rogertheriault/thing-thermometer/assets/gas-stove-bg.jpg

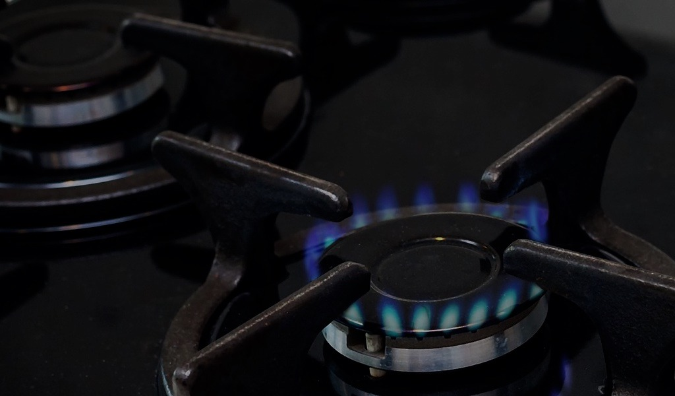
assets/gas-stove-bg.jpg
