rogertheriault/thing-thermometer/assets/thermometer-512.png

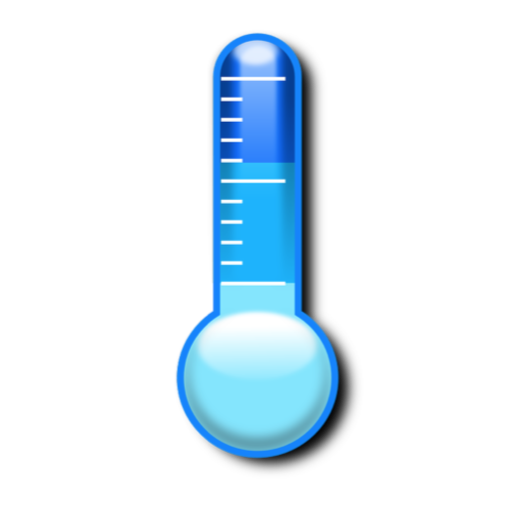
assets/thermometer-512.png
