rogertheriault/thing-thermometer/img/display.jpg

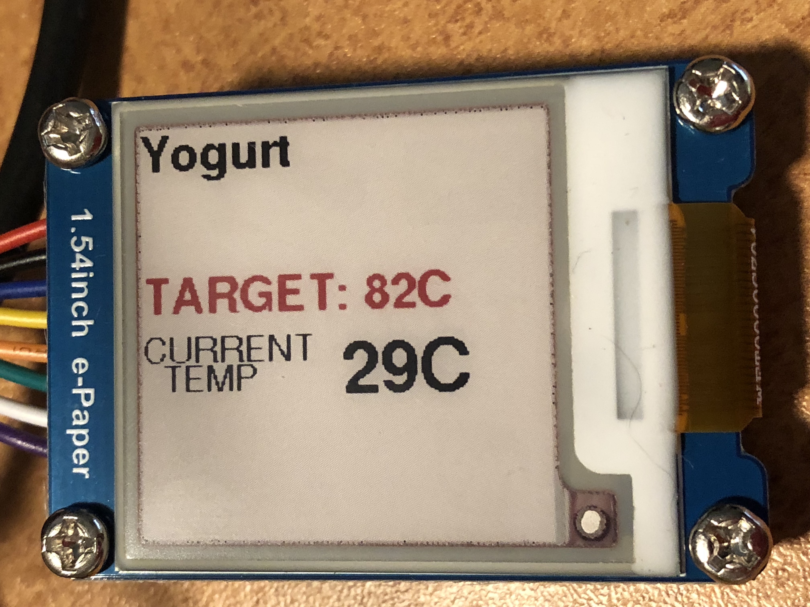
img/display.jpg
