rogertheriault/thing-thermometer/ThermometerAWSIoT/display.h

 
/**
 * E-paper display code
 */
 
#include <SPI.h>
#include <GxEPD.h>

#define DISPLAY_BGCOLOR GxEPD_WHITE
#define DISPLAY_FGCOLOR GxEPD_BLACK
#define DISPLAY_HICOLOR GxEPD_BLACK

// if you have other sizes, see the GxEPD library examples
#ifdef DISPLAY_3COLOR
#include <GxGDEW0154Z04/GxGDEW0154Z04.cpp>  // 1.54" b/w/r
#define DISPLAY_HICOLOR GxEPD_RED
#else
#include <GxGDEP015OC1/GxGDEP015OC1.cpp> // 1.54" b/w
#endif
// free fonts from Adafruit_GFX
#include <Fonts/FreeSans9pt7b.h>
#include <Fonts/FreeSansBold12pt7b.h>
#include <Fonts/FreeSansBold18pt7b.h>

#include <GxIO/GxIO_SPI/GxIO_SPI.cpp>
#include <GxIO/GxIO.cpp>


GxIO_Class io(SPI, EPAPER_CS, EPAPER_DC, EPAPER_RST);
GxEPD_Class display(io, EPAPER_RST, EPAPER_BUSY);


// update the e-paper display
void updateDisplay() {
  if ( ! display_update) {
    return;
  }
  display_update = false;
  
  display.fillScreen(DISPLAY_BGCOLOR);
  display.setTextColor(DISPLAY_FGCOLOR);

  Serial.print(F("DISPLAY heap size: "));
  Serial.println(ESP.getFreeHeap());

  /*
  // test
  // get a bitmap and size from a SPIFFS file
  uint16_t bmW, bmH;
  uint8_t *myBitmap = getBitmapFromFS("/yogurt.bin", bmW, bmH);
  display.drawBitmap(myBitmap, 0, 30, bmW, bmH, DISPLAY_FGCOLOR);
  Serial.print(F("DRAW heap size: \n"));
  Serial.println(ESP.getFreeHeap());
  display.update();
  Serial.print(F("UPDATE heap size: "));
  Serial.println(ESP.getFreeHeap());
  //delete [] myBitmap;
  Serial.print(F("DELETE heap size: "));
  Serial.println(ESP.getFreeHeap());
  return;
*/
   
  // what we're cooking
  display.setFont(&FreeSansBold12pt7b);
  display.setCursor(0, 20);
  // TODO center
  display.print( recipe_title );

  // battery
  //display.setCursor(160, 20);
  //display.print( ESP.getVcc() );

  // current temperature & step
  display.setFont(&FreeSans9pt7b);
  display.setCursor(0, 40);


  display.print( recipe_step_text );

  display.setCursor(0, 114);
  display.print(F("CURRENT"));
  display.setCursor(10, 128);
  display.print(F("TEMP"));
  display.setCursor(0, 32);

  // if the alarm's on, temp should be red
  if (in_alarm_state) {
    display.setTextColor(DISPLAY_HICOLOR);
  }
  if (currentTemp > 0) {
    display.setFont(&FreeSansBold18pt7b);
    display.setCursor(100, 130);
    display.print(currentTemp);
    display.println(F("C"));
  } else {
    display.setTextColor(DISPLAY_HICOLOR);
    display.setCursor(100, 130);
    // TODO icon here
    display.println(F("probe!"));
  }

  // if alarm is enabled show target temp(s)
  if (watching_high || watching_low) {
    display.setFont(&FreeSansBold12pt7b);
    display.setTextColor(DISPLAY_HICOLOR);
    display.setCursor(0, 90);
    display.print(F("TARGET: "));
    if (watching_low) {
      display.print(alarm_low);
    }
    if (watching_low && watching_high) {
      display.print(F("-"));
    }
    if (watching_high) {
      display.print(alarm_high);
    }
    display.print(F("C"));
  }

  display.update();
}
