rogertheriault/thing-thermometer/ThermometerAWSIoT/config-sample.h

// KEYS

// Keep this in config.h and keep it private!
// Even so, keep your devices secure, do not use this method
// for a production device

/*********WiFi settings*******/
#define WLAN_SSID "your-wifi-ssid"
#define WLAN_PASS "your-wifi-passphrase"
/*****************************/

/*********AWS IoT Thing settings*******/
#define AWS_SERVERPORT 443
#define AWS_REGION "us-east-1"
#define AWS_ENDPOINT "your-endpoint.iot.us-east-1.amazonaws.com"
#define THING_ID "your-thing-id"
#define AWS_KEY_ID "your-aws-key-id"
#define AWS_KEY_SECRET "your-aws-key-secret"

/*********S3 Settings********/
#define THING_DATA "http://s3.amazonaws.com/my-bucket"
#define RECIPES_URL "http://s3.amazonaws.com/my-bucket/recipes.json"
