rogertheriault/thing-thermometer/(commit log)

2018-01-08 initial (working) version of Arduino/ESP8266 code
2018-01-10 construct update JSON, parse inbound JSON correctly, and add cooking mode to display
    [ThermometerAWSIoT.ino]
2018-01-25 sample interactions
2018-01-26 use recipes.json on device
2018-02-18 breathe LEDS breathe
2018-02-19 update sample config
2018-02-24 couple more comment fixes
    [awsiot.h, display.h]
